tast2129/Grooving-Shredders/README.md

# This is the git for The Grooving Shredders 23-24 Capstone Team

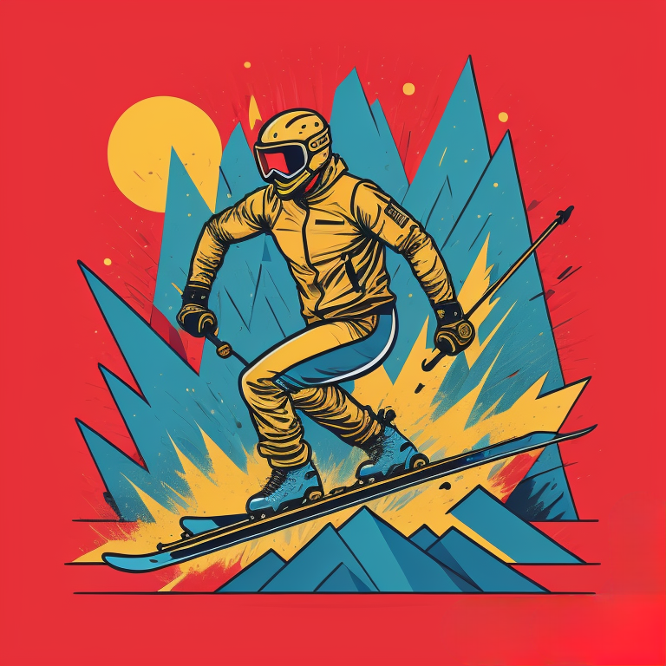
[picture p1: Images/Grooving Shredders Final Logo.png]


Project Sponsor: Augustus Aerospace

Frequency band: 1.24GHz

Git contact: Wes McEvoy @ westonmcevoy@gmail.com

# Table of Contents

* For patch antenna design of phased array see files in "AnsysHFSS"
* For HackRF and Pluto transmitter code see files in "GNU Radio"
* For delay and sum beamforming algorithm see:
  * "Python": "delay_and_sum_synthesis.ipynb"
* For beamforming IP block (in construction, low-level implementation of delay and sum algorithm) see files in "HDL"
* For RFSoC PYNQ layer code see "PYNQ"
* For motor code and hardware setup image, see "Arduino"
* For PCB files for AFE and patch antennas see "Gerber Files"

# Project Background

For 8 months, our team worked to build a digital beamformer in the FPGA fabric of the RFSoC 4x2 by AMD Xilinx. Although we ran out of time to fully debug the hardware configuration we developed, we learned a lot about the board, RF, and DSP and generated some pretty cool results along the way. All radiation patterns seen on this git were generated with the help of our custom test system.

System Flowchart:
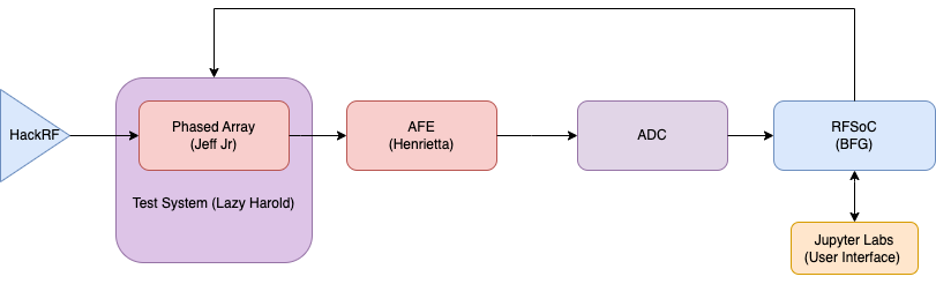
[picture p2: Images/Flowchart.png]
Flowchart


# Custom Components

Phased Array:

Phased_Array

Turntable Test System:

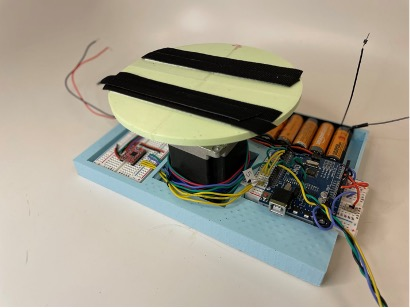
[picture p3: Images/Test_System.jpg]
Test_System


Analog Front End Board:

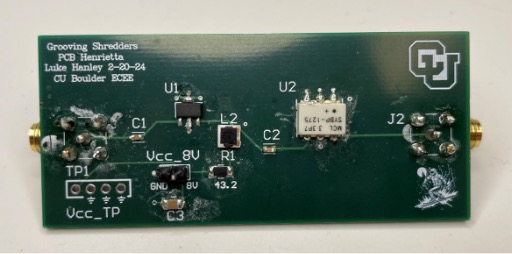
[picture p4: Images/AFE_PCB.jpg]
AFE_PCB


# Results

The environment we generated the following results in:

Setup

Radiation Pattern for COTS Dipole Antenna:

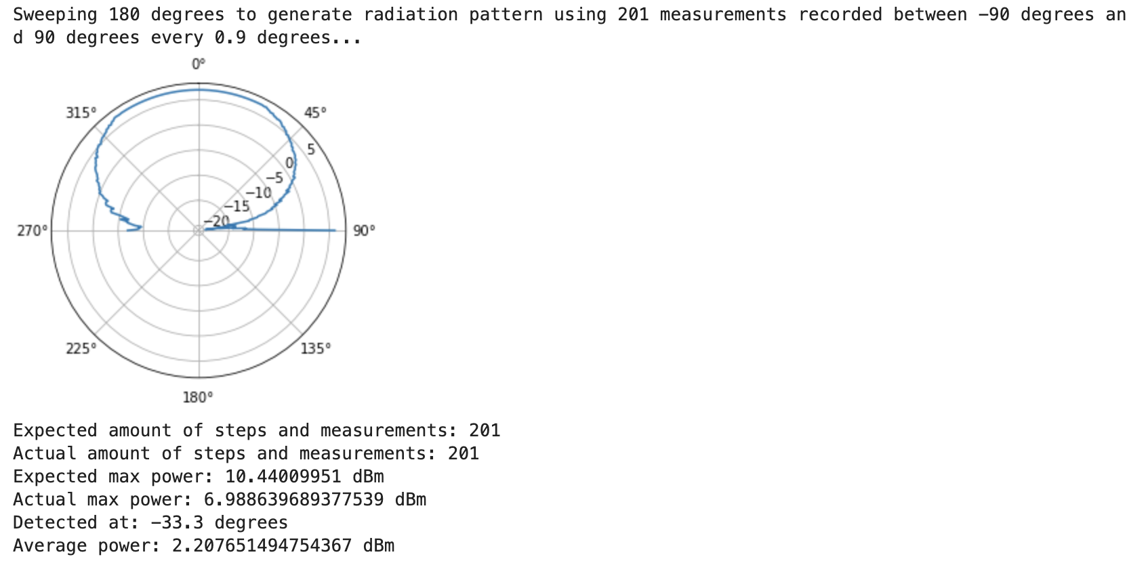
[picture p5: Images/Dipole_Pattern.png]
Dipole_Pattern


Radiation Pattern for Custom Patch Antenna:

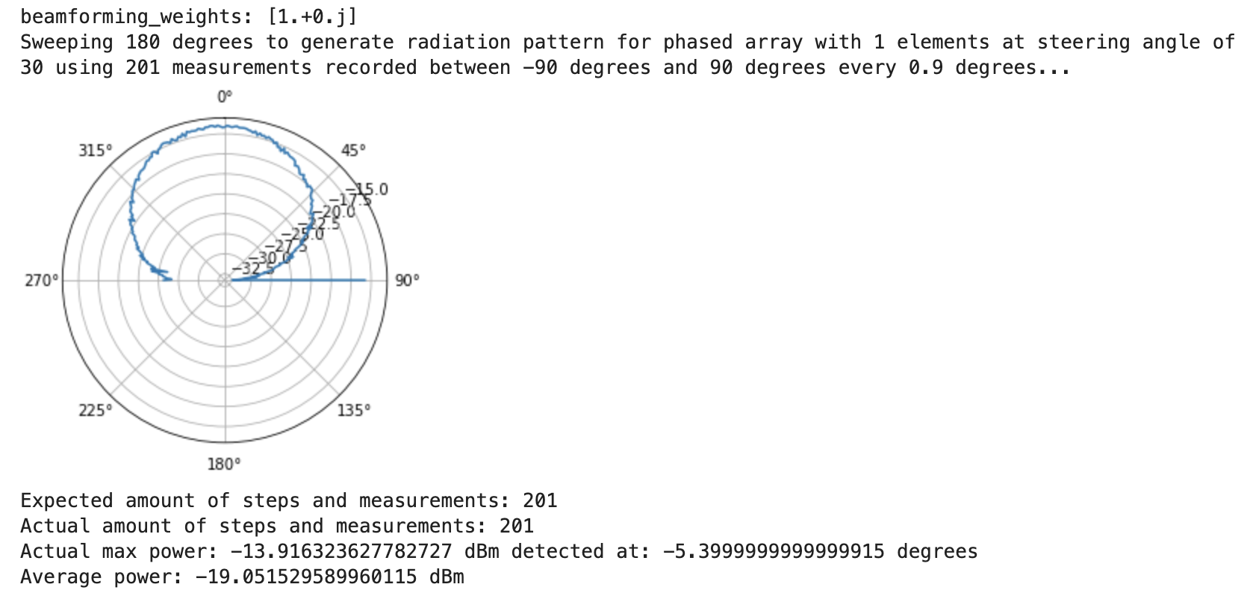
[picture p6: Images/Patch_Pattern.png]
Patch_Pattern


Normalized Radiation Pattern for Phased Array performing Analog Beamforming:

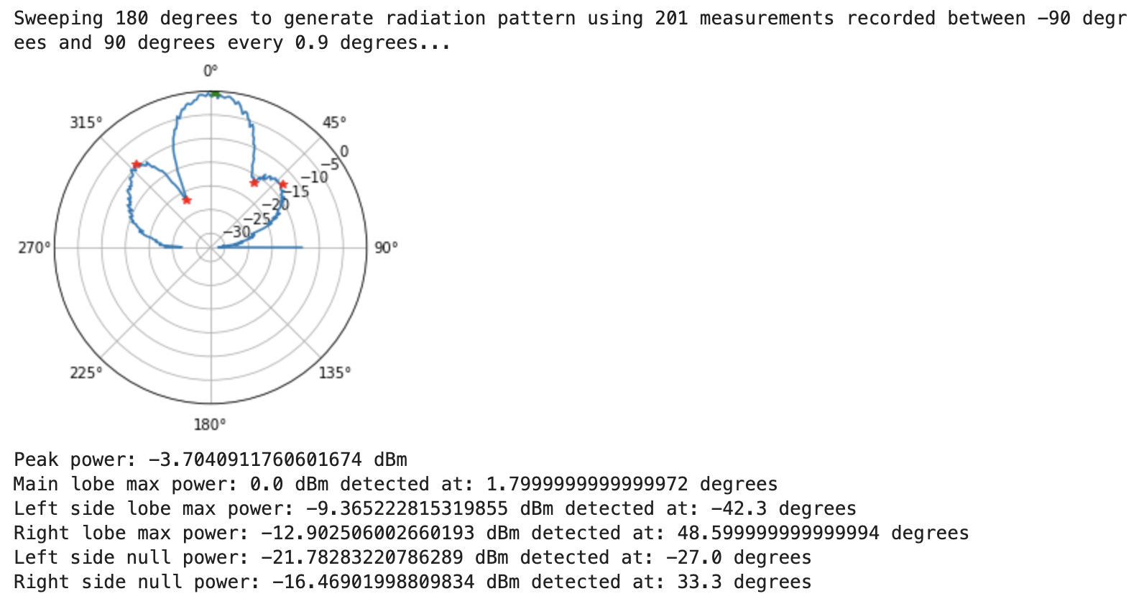
[picture p7: Images/Broadside_Pattern.png]
Array_Pattern


The best looking radiation pattern we generated:

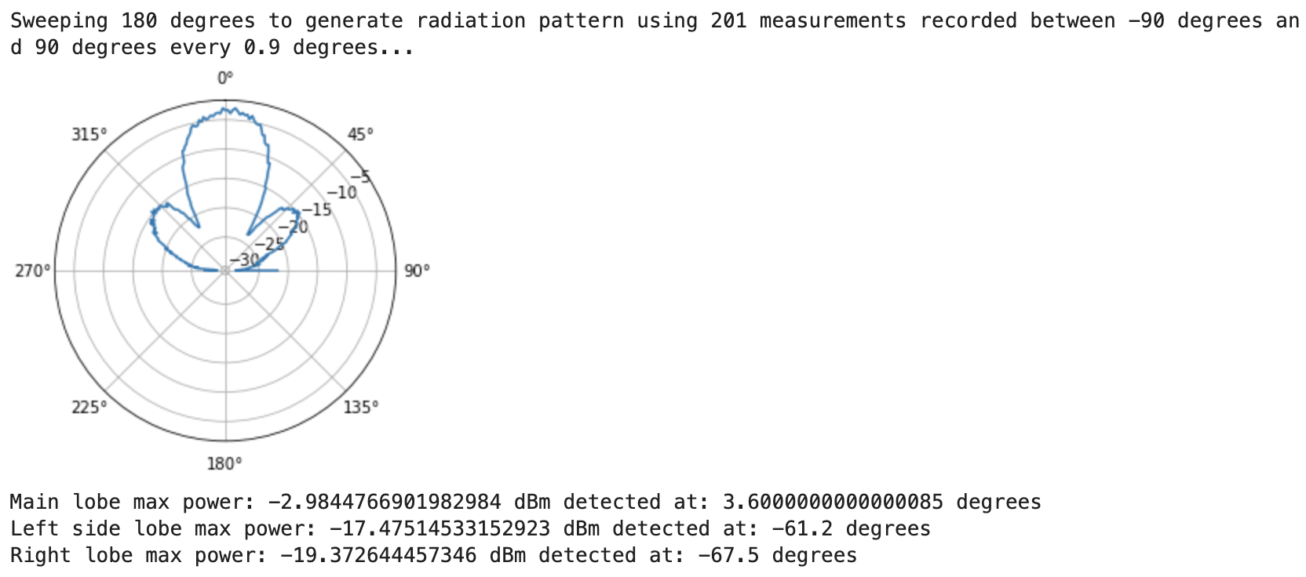
[picture p8: Images/Phased_Array_Pattern.png]
Pristine_Pattern


# Delay and sum algorithm synthesized by "delay_and_sum_synthesis.ipynb" in "Python"

Whenever a transmitter is located at some angle off of a phased array's broadside, each element receives the same signal with a different phase shift:

beamforming1

If we try to sum the signal received by the 4 elements, we get a lot of nonsense:

beamforming2

Instead, let's undo the phase shifts by multiplying each element's data by beamforming weights calculated using simple trig and the known angle of the transmitter off of the array's broadside and the spacing of the elements in the array:

beamforming3

Now when we sum the signal received by the 4 elements, not only have we received the original transmitted signal, but with around 4x the amplitude!

beamforming4

For this reason, it's incredibly important to ensure any phase shifts induced by hardware are corrected or compensated so as to make the beamforming as effective as possible:

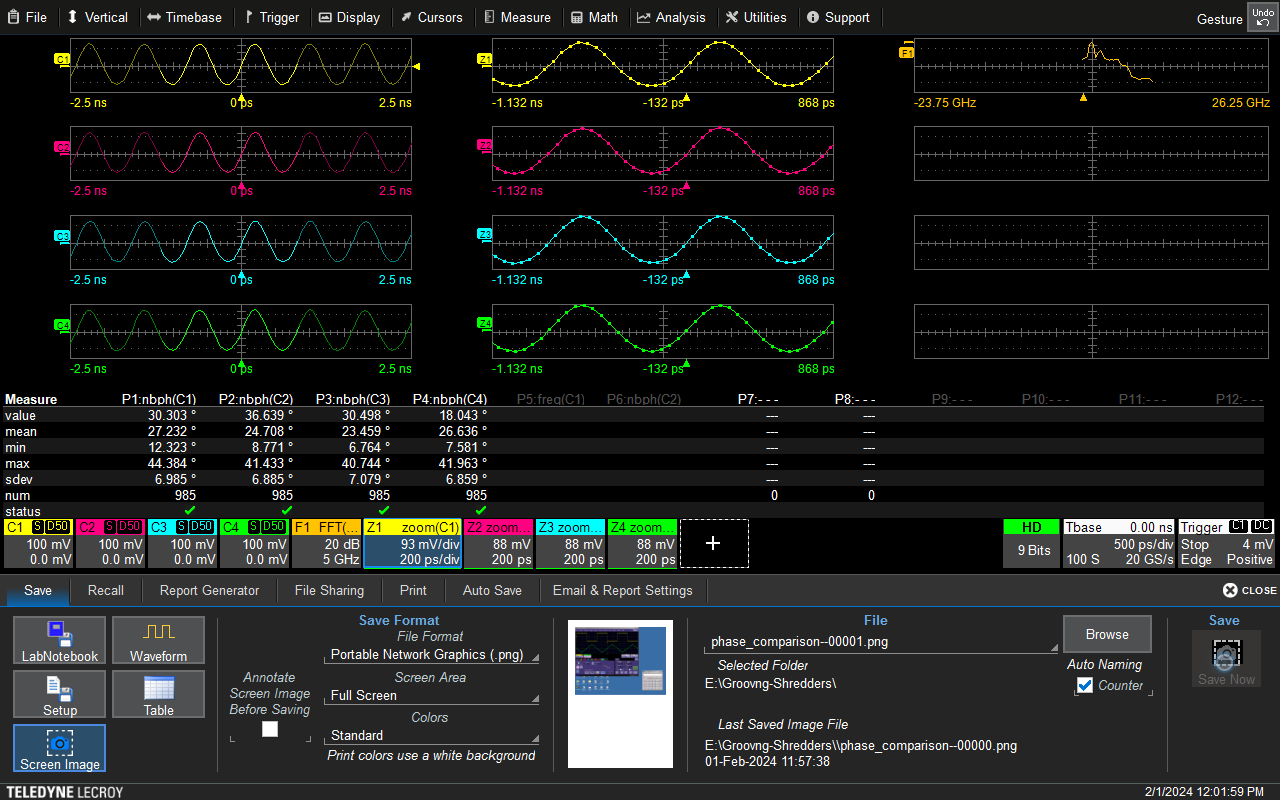
[picture p9: Images/Scope_Phase.png]
Phase


# References

https://www.rfsoc-pynq.io/

https://pynq.readthedocs.io/en/latest/

https://www.xilinx.com/products/design-tools/vitis/vitis-hls.html#resources

https://discuss.pynq.io/

https://docs.amd.com/r/en-US/ds926-zynq-ultrascale-plus-rfsoc/RF-ADC-Electrical-Characteristics

https://pysdr.org/content/doa.html
