tast2129/Grooving-Shredders/Images/Test_Setup1.jpeg

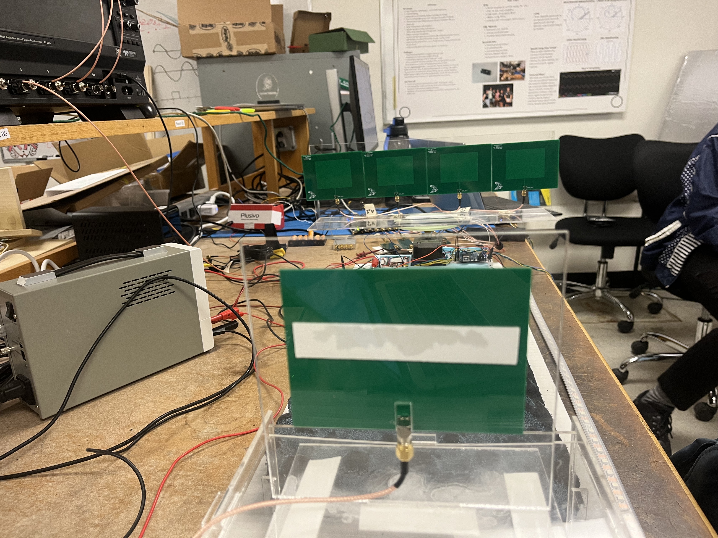
Images/Test_Setup1.jpeg
