tast2129/Grooving-Shredders/HDL/Auxilary_Modules/AXI_AdderBase.v

/* 
 * AXI data adder block taking four 128-bit input data and outputs them
 * This block is completely unnecessary and serves to confirm we're interfacing
 * correctly before implementing the adder portion of this block
*/
module axi_adder #(
    parameter SDATA_WIDTH = 128,
    parameter MDATA_WIDTH = 128,     // SDATA_WIDTH + 1
    parameter SSAMPLE_WIDTH = 8,
    parameter MSAMPLE_WIDTH = 8,   // SSAMPLE_WIDTH
    parameter WEIGHT_WIDTH = 8
    ) 
    (
    input clock,
    input resetn,

    // these will be the multiplication factor for all 16 samples in each channel, each should be <1
    input [WEIGHT_WIDTH-1:0] bWeight00_imag, input [WEIGHT_WIDTH-1:0] bWeight00_real,
    input [WEIGHT_WIDTH-1:0] bWeight01_imag, input [WEIGHT_WIDTH-1:0] bWeight01_real,
    input [WEIGHT_WIDTH-1:0] bWeight20_imag, input [WEIGHT_WIDTH-1:0] bWeight20_real,
    input [WEIGHT_WIDTH-1:0] bWeight21_imag, input [WEIGHT_WIDTH-1:0] bWeight21_real,
    
    /* all axis prefixed variables should be inferred per UG994 because of the 
     * use of the AXI standard naming convention */

    input [0:0]             S00_axi_awid,
    input [48:0]            S00_axi_awaddr,
    input [7:0]             S00_axi_awlen,
    input [2:0]             S00_axi_awsize,
    input [1:0]             S00_axi_awburst,
    input                   S00_axi_awlock,
    input [3:0]             S00_axi_awcache,
    input [2:0]             S00_axi_awprot,
    input                   S00_axi_awregion,
    input [3:0]             S00_axi_awqos,
    input                   S00_axi_awvalid, //zero when reset
    output                  S00_axi_awready, //zero when reset
    input [15:0]            S00_axi_wstrb,
    input                   S00_axi_wlast,
    input                   S00_axi_wvalid, //zero when reset
    output                  S00_axi_wready, //zero when reset
    output [5:0]            S00_axi_bid,
    output [1:0]            S00_axi_bresp,
    output                  S00_axi_bvalid, //zero when reset
    input                   S00_axi_bready, //zero when reset
    input [SDATA_WIDTH-1:0] S00_axi_wdata, // 16 8-bit samples
    input [5:0]             S00_axi_arid,
    input [63:0]            S00_axi_araddr,
    input [7:0]             S00_axi_arlen,
    input [2:0]             S00_axi_arsize,
    input [1:0]             S00_axi_arburst,
    input                   S00_axi_arlock,
    input [3:0]             S00_axi_arcache,
    input [2:0]             S00_axi_arprot,
    input                   S00_axi_arregion,
    input [3:0]             S00_axi_arqos,
    input                   S00_axi_arvalid, //zero when reset
    output                  S00_axi_arready, //zero when reset
    output [1:0]            S00_axi_rresp,
    output                  S00_axi_rlast,
    output                  S00_axi_rvalid, //zero when reset
    input                   S00_axi_rready, //zero when reset
    output[SDATA_WIDTH-1:0] S00_axi_rdata, // 16 8-bit samples
		
    input [5:0]             S01_axi_awid,
    input [48:0]            S01_axi_awaddr,
    input [7:0]             S01_axi_awlen,
    input [2:0]             S01_axi_awsize,
    input [1:0]             S01_axi_awburst,
    input                   S01_axi_awlock,
    input [3:0]             S01_axi_awcache,
    input [2:0]             S01_axi_awprot,
    input                   S01_axi_awregion,
    input [3:0]             S01_axi_awqos,
    input                   S01_axi_awvalid, //zero when reset
    output                  S01_axi_awready, //zero when reset
    input [15:0]            S01_axi_wstrb,
    input                   S01_axi_wlast,
    input                   S01_axi_wvalid, //zero when reset
    output                  S01_axi_wready, //zero when reset
    output [5:0]            S01_axi_bid,
    output [1:0]            S01_axi_bresp,
    output                  S01_axi_bvalid, //zero when reset
    input                   S01_axi_bready, //zero when reset
    input [SDATA_WIDTH-1:0] S01_axi_wdata, // 16 8-bit samples
    input [5:0]             S01_axi_arid,
    input [63:0]            S01_axi_araddr,
    input [7:0]             S01_axi_arlen,
    input [2:0]             S01_axi_arsize,
    input [1:0]             S01_axi_arburst,
    input                   S01_axi_arlock,
    input [3:0]             S01_axi_arcache,
    input [2:0]             S01_axi_arprot,
    input                   S01_axi_arregion,
    input [3:0]             S01_axi_arqos,
    input                   S01_axi_arvalid, //zero when reset
    output                  S01_axi_arready, //zero when reset
    output [1:0]            S01_axi_rresp,
    output                  S01_axi_rlast,
    output                  S01_axi_rvalid, //zero when reset
    input                   S01_axi_rready, //zero when reset
    output[SDATA_WIDTH-1:0] S01_axi_rdata, // 16 8-bit samples
		
    input [5:0]             S21_axi_awid,
    input [48:0]            S21_axi_awaddr,
    input [7:0]             S21_axi_awlen,
    input [2:0]             S21_axi_awsize,
    input [1:0]             S21_axi_awburst,
    input                   S21_axi_awlock,
    input [3:0]             S21_axi_awcache,
    input [2:0]             S21_axi_awprot,
    input                   S21_axi_awregion,
    input [3:0]             S21_axi_awqos,
    input                   S21_axi_awvalid, //zero when reset
    output                  S21_axi_awready, //zero when reset
    input [15:0]            S21_axi_wstrb,
    input                   S21_axi_wlast,
    input                   S21_axi_wvalid, //zero when reset
    output                  S21_axi_wready, //zero when reset
    output [5:0]            S21_axi_bid,
    output [1:0]            S21_axi_bresp,
    output                  S21_axi_bvalid, //zero when reset
    input                   S21_axi_bready, //zero when reset
    input [SDATA_WIDTH-1:0] S21_axi_wdata, // 16 8-bit samples
    input [5:0]             S21_axi_arid,
    input [63:0]            S21_axi_araddr,
    input [7:0]             S21_axi_arlen,
    input [2:0]             S21_axi_arsize,
    input [1:0]             S21_axi_arburst,
    input                   S21_axi_arlock,
    input [3:0]             S21_axi_arcache,
    input [2:0]             S21_axi_arprot,
    input                   S21_axi_arregion,
    input [3:0]             S21_axi_arqos,
    input                   S21_axi_arvalid, //zero when reset
    output                  S21_axi_arready, //zero when reset
    output [1:0]            S21_axi_rresp,
    output                  S21_axi_rlast,
    output                  S21_axi_rvalid, //zero when reset
    input                   S21_axi_rready, //zero when reset
    output[SDATA_WIDTH-1:0] S21_axi_rdata, // 16 8-bit samples
		
    input [5:0]             S20_axi_awid,
    input [48:0]            S20_axi_awaddr,
    input [7:0]             S20_axi_awlen,
    input [2:0]             S20_axi_awsize,
    input [1:0]             S20_axi_awburst,
    input                   S20_axi_awlock,
    input [3:0]             S20_axi_awcache,
    input [2:0]             S20_axi_awprot,
    input                   S20_axi_awregion,
    input [3:0]             S20_axi_awqos,
    input                   S20_axi_awvalid, //zero when reset
    output                  S20_axi_awready, //zero when reset
    input [15:0]            S20_axi_wstrb,
    input                   S20_axi_wlast,
    input                   S20_axi_wvalid, //zero when reset
    output                  S20_axi_wready, //zero when reset
    output [5:0]            S20_axi_bid,
    output [1:0]            S20_axi_bresp,
    output                  S20_axi_bvalid, //zero when reset
    input                   S20_axi_bready, //zero when reset
    input [SDATA_WIDTH-1:0] S20_axi_wdata, // 16 8-bit samples
    input [5:0]             S20_axi_arid,
    input [63:0]            S20_axi_araddr,
    input [7:0]             S20_axi_arlen,
    input [2:0]             S20_axi_arsize,
    input [1:0]             S20_axi_arburst,
    input                   S20_axi_arlock,
    input [3:0]             S20_axi_arcache,
    input [2:0]             S20_axi_arprot,
    input                   S20_axi_arregion,
    input [3:0]             S20_axi_arqos,
    input                   S20_axi_arvalid, //zero when reset
    output                  S20_axi_arready, //zero when reset
    output [1:0]            S20_axi_rresp,
    output                  S20_axi_rlast,
    output                  S20_axi_rvalid, //zero when reset
    input                   S20_axi_rready, //zero when reset
    output[SDATA_WIDTH-1:0] S20_axi_rdata, // 16 8-bit samples
	
    output [5:0]            M00_axi_awid,
    output [48:0]           M00_axi_awaddr,
    output [7:0]            M00_axi_awlen,
    output [2:0]            M00_axi_awsize,
    output [1:0]            M00_axi_awburst,
    output                  M00_axi_awlock,
    output [3:0]            M00_axi_awcache,
    output [2:0]            M00_axi_awprot,
    output                  M00_axi_awregion,
    output [3:0]            M00_axi_awqos,
    output                  M00_axi_awvalid, //zero when reset
    input                   M00_axi_awready, //zero when reset
    output [15:0]           M00_axi_wstrb,
    output                  M00_axi_wlast,
    output                  M00_axi_wvalid, //zero when reset
    input                   M00_axi_wready, //zero when reset
    output[MDATA_WIDTH-1:0] M00_axi_wdata, // 16 8-bit samples
    output [5:0]            M00_axi_arid,
    output [63:0]           M00_axi_araddr,
    output [7:0]            M00_axi_arlen,
    output [2:0]            M00_axi_arsize,
    output [1:0]            M00_axi_arburst,
    output                  M00_axi_arlock,
    output [3:0]            M00_axi_arcache,
    output [2:0]            M00_axi_arprot,
    output                  M00_axi_arregion,
    output [3:0]            M00_axi_arqos,
    output                  M00_axi_arvalid, //zero when reset
    input                   M00_axi_arready, //zero when reset
    input  [1:0]            M00_axi_rresp,
    input                   M00_axi_rlast,
    input                   M00_axi_rvalid, //zero when reset
    output                  M00_axi_rready, //zero when reset
    input  [5:0]            M00_axi_bid,
    input  [1:0]            M00_axi_bresp,
    input                   M00_axi_bvalid, //zero when reset
    output                  M00_axi_bready, //zero when reset
    input [MDATA_WIDTH-1:0] M00_axi_rdata, // 16 8-bit samples

    output [5:0]            M01_axi_awid,
    output [48:0]           M01_axi_awaddr,
    output [7:0]            M01_axi_awlen,
    output [2:0]            M01_axi_awsize,
    output [1:0]            M01_axi_awburst,
    output                  M01_axi_awlock,
    output [3:0]            M01_axi_awcache,
    output [2:0]            M01_axi_awprot,
    output                  M01_axi_awregion,
    output [3:0]            M01_axi_awqos,
    output                  M01_axi_awvalid, //zero when reset
    input                   M01_axi_awready, //zero when reset
    output [15:0]           M01_axi_wstrb,
    output                  M01_axi_wlast,
    output                  M01_axi_wvalid, //zero when reset
    input                   M01_axi_wready, //zero when reset
    output[MDATA_WIDTH-1:0] M01_axi_wdata, // 16 8-bit samples
    output [5:0]            M01_axi_arid,
    output [63:0]           M01_axi_araddr,
    output [7:0]            M01_axi_arlen,
    output [2:0]            M01_axi_arsize,
    output [1:0]            M01_axi_arburst,
    output                  M01_axi_arlock,
    output [3:0]            M01_axi_arcache,
    output [2:0]            M01_axi_arprot,
    output                  M01_axi_arregion,
    output [3:0]            M01_axi_arqos,
    output                  M01_axi_arvalid, //zero when reset
    input                   M01_axi_arready, //zero when reset
    input  [1:0]            M01_axi_rresp,
    input                   M01_axi_rlast,
    input                   M01_axi_rvalid, //zero when reset
    output                  M01_axi_rready, //zero when reset
    input  [5:0]            M01_axi_bid,
    input  [1:0]            M01_axi_bresp,
    input                   M01_axi_bvalid, //zero when reset
    output                  M01_axi_bready, //zero when reset
    input [MDATA_WIDTH-1:0] M01_axi_rdata, // 16 8-bit samples

    output [5:0]            M21_axi_awid,
    output [48:0]           M21_axi_awaddr,
    output [7:0]            M21_axi_awlen,
    output [2:0]            M21_axi_awsize,
    output [1:0]            M21_axi_awburst,
    output                  M21_axi_awlock,
    output [3:0]            M21_axi_awcache,
    output [2:0]            M21_axi_awprot,
    output                  M21_axi_awregion,
    output [3:0]            M21_axi_awqos,
    output                  M21_axi_awvalid, //zero when reset
    input                   M21_axi_awready, //zero when reset
    output [15:0]           M21_axi_wstrb,
    output                  M21_axi_wlast,
    output                  M21_axi_wvalid, //zero when reset
    input                   M21_axi_wready, //zero when reset
    output[MDATA_WIDTH-1:0] M21_axi_wdata, // 16 8-bit samples
    output [5:0]            M21_axi_arid,
    output [63:0]           M21_axi_araddr,
    output [7:0]            M21_axi_arlen,
    output [2:0]            M21_axi_arsize,
    output [1:0]            M21_axi_arburst,
    output                  M21_axi_arlock,
    output [3:0]            M21_axi_arcache,
    output [2:0]            M21_axi_arprot,
    output                  M21_axi_arregion,
    output [3:0]            M21_axi_arqos,
    output                  M21_axi_arvalid, //zero when reset
    input                   M21_axi_arready, //zero when reset
    input  [1:0]            M21_axi_rresp,
    input                   M21_axi_rlast,
    input                   M21_axi_rvalid, //zero when reset
    output                  M21_axi_rready, //zero when reset
    input  [5:0]            M21_axi_bid,
    input  [1:0]            M21_axi_bresp,
    input                   M21_axi_bvalid, //zero when reset
    output                  M21_axi_bready, //zero when reset
    input [MDATA_WIDTH-1:0] M21_axi_rdata, // 16 8-bit samples
    
    output [5:0]            M20_axi_awid,
    output [48:0]           M20_axi_awaddr,
    output [7:0]            M20_axi_awlen,
    output [2:0]            M20_axi_awsize,
    output [1:0]            M20_axi_awburst,
    output                  M20_axi_awlock,
    output [3:0]            M20_axi_awcache,
    output [2:0]            M20_axi_awprot,
    output                  M20_axi_awregion,
    output [3:0]            M20_axi_awqos,
    output                  M20_axi_awvalid, //zero when reset
    input                   M20_axi_awready, //zero when reset
    output [15:0]           M20_axi_wstrb,
    output                  M20_axi_wlast,
    output                  M20_axi_wvalid, //zero when reset
    input                   M20_axi_wready, //zero when reset
    output[MDATA_WIDTH-1:0] M20_axi_wdata, // 16 8-bit samples
    output [5:0]            M20_axi_arid,
    output [63:0]           M20_axi_araddr,
    output [7:0]            M20_axi_arlen,
    output [2:0]            M20_axi_arsize,
    output [1:0]            M20_axi_arburst,
    output                  M20_axi_arlock,
    output [3:0]            M20_axi_arcache,
    output [2:0]            M20_axi_arprot,
    output                  M20_axi_arregion,
    output [3:0]            M20_axi_arqos,
    output                  M20_axi_arvalid, //zero when reset
    input                   M20_axi_arready, //zero when reset
    input  [1:0]            M20_axi_rresp,
    input                   M20_axi_rlast,
    input                   M20_axi_rvalid, //zero when reset
    output                  M20_axi_rready, //zero when reset
    input  [5:0]            M20_axi_bid,
    input  [1:0]            M20_axi_bresp,
    input                   M20_axi_bvalid, //zero when reset
    output                  M20_axi_bready, //zero when reset
    input [MDATA_WIDTH-1:0] M20_axi_rdata // 16 8-bit samples
    );

    assign M00_axi_awid = S00_axi_awid;
    assign M00_axi_awaddr = S00_axi_awaddr;
    assign M00_axi_awlen = S00_axi_awlen;
    assign M00_axi_awsize = S00_axi_awsize;
    assign M00_axi_awburst = S00_axi_awburst;
    assign M00_axi_awlock = S00_axi_awlock;
    assign M00_axi_awcache = S00_axi_awcache;
    assign M00_axi_awprot = S00_axi_awprot;
    assign M00_axi_awregion = S00_axi_awregion;
    assign M00_axi_awqos = S00_axi_awqos;
    assign M00_axi_awvalid = S00_axi_awvalid;
    assign M00_axi_awready = S00_axi_awready; //zero when reset
    assign M00_axi_wstrb = S00_axi_wstrb;
    assign M00_axi_wlast = S00_axi_wlast;
    assign M00_axi_wvalid = S00_axi_wvalid; //zero when reset
    assign M00_axi_wready = S00_axi_wready; //zero when reset
    assign M00_axi_bid = S00_axi_bid;
    assign M00_axi_bresp = S00_axi_bresp;
    assign M00_axi_bvalid = S00_axi_bvalid; //zero when reset
    assign M00_axi_bready = S00_axi_bready; //zero when reset
    assign M00_axi_wdata = S00_axi_wdata; // 16 8-bit samples
    assign M00_axi_arid = S00_axi_arid;
    assign M00_axi_araddr = S00_axi_araddr;
    assign M00_axi_arlen = S00_axi_arlen;
    assign M00_axi_arsize = S00_axi_arsize;
    assign M00_axi_arburst = S00_axi_arburst;
    assign M00_axi_arlock = S00_axi_arlock;
    assign M00_axi_arcache = S00_axi_arcache;
    assign M00_axi_arprot = S00_axi_arprot;
    assign M00_axi_arregion = S00_axi_arregion;
    assign M00_axi_arqos = S00_axi_arqos;
    assign M00_axi_arvalid = S00_axi_arvalid; //zero when reset
    assign M00_axi_arready = S00_axi_arready; //zero when reset
    assign M00_axi_rresp = S00_axi_rresp;
    assign M00_axi_rlast = S00_axi_rlast;
    assign M00_axi_rvalid = S00_axi_rvalid; //zero when reset
    assign M00_axi_rready = S00_axi_rready; //zero when reset
    assign M00_axi_rdata = S00_axi_rdata; // 16 8-bit samples

    assign M01_axi_awid = S01_axi_awid;
    assign M01_axi_awaddr = S01_axi_awaddr;
    assign M01_axi_awlen = S01_axi_awlen;
    assign M01_axi_awsize = S01_axi_awsize;
    assign M01_axi_awburst = S01_axi_awburst;
    assign M01_axi_awlock = S01_axi_awlock;
    assign M01_axi_awcache = S01_axi_awcache;
    assign M01_axi_awprot = S01_axi_awprot;
    assign M01_axi_awregion = S01_axi_awregion;
    assign M01_axi_awqos = S01_axi_awqos;
    assign M01_axi_awvalid = S01_axi_awvalid;
    assign M01_axi_awready = S01_axi_awready; //zero when reset
    assign M01_axi_wstrb = S01_axi_wstrb;
    assign M01_axi_wlast = S01_axi_wlast;
    assign M01_axi_wvalid = S01_axi_wvalid; //zero when reset
    assign M01_axi_wready = S01_axi_wready; //zero when reset
    assign M01_axi_bid = S01_axi_bid;
    assign M01_axi_bresp = S01_axi_bresp;
    assign M01_axi_bvalid = S01_axi_bvalid; //zero when reset
    assign M01_axi_bready = S01_axi_bready; //zero when reset
    assign M01_axi_wdata = S01_axi_wdata; // 16 8-bit samples
    assign M01_axi_arid = S01_axi_arid;
    assign M01_axi_araddr = S01_axi_araddr;
    assign M01_axi_arlen = S01_axi_arlen;
    assign M01_axi_arsize = S01_axi_arsize;
    assign M01_axi_arburst = S01_axi_arburst;
    assign M01_axi_arlock = S01_axi_arlock;
    assign M01_axi_arcache = S01_axi_arcache;
    assign M01_axi_arprot = S01_axi_arprot;
    assign M01_axi_arregion = S01_axi_arregion;
    assign M01_axi_arqos = S01_axi_arqos;
    assign M01_axi_arvalid = S01_axi_arvalid; //zero when reset
    assign M01_axi_arready = S01_axi_arready; //zero when reset
    assign M01_axi_rresp = S01_axi_rresp;
    assign M01_axi_rlast = S01_axi_rlast;
    assign M01_axi_rvalid = S01_axi_rvalid; //zero when reset
    assign M01_axi_rready = S01_axi_rready; //zero when reset
    assign M01_axi_rdata = S01_axi_rdata; // 16 8-bit samples

    assign M20_axi_awid = S20_axi_awid;
    assign M20_axi_awaddr = S20_axi_awaddr;
    assign M20_axi_awlen = S20_axi_awlen;
    assign M20_axi_awsize = S20_axi_awsize;
    assign M20_axi_awburst = S20_axi_awburst;
    assign M20_axi_awlock = S20_axi_awlock;
    assign M20_axi_awcache = S20_axi_awcache;
    assign M20_axi_awprot = S20_axi_awprot;
    assign M20_axi_awregion = S20_axi_awregion;
    assign M20_axi_awqos = S20_axi_awqos;
    assign M20_axi_awvalid = S20_axi_awvalid;
    assign M20_axi_awready = S20_axi_awready; //zero when reset
    assign M20_axi_wstrb = S20_axi_wstrb;
    assign M20_axi_wlast = S20_axi_wlast;
    assign M20_axi_wvalid = S20_axi_wvalid; //zero when reset
    assign M20_axi_wready = S20_axi_wready; //zero when reset
    assign M20_axi_bid = S20_axi_bid;
    assign M20_axi_bresp = S20_axi_bresp;
    assign M20_axi_bvalid = S20_axi_bvalid; //zero when reset
    assign M20_axi_bready = S20_axi_bready; //zero when reset
    assign M20_axi_wdata = S20_axi_wdata; // 16 8-bit samples
    assign M20_axi_arid = S20_axi_arid;
    assign M20_axi_araddr = S20_axi_araddr;
    assign M20_axi_arlen = S20_axi_arlen;
    assign M20_axi_arsize = S20_axi_arsize;
    assign M20_axi_arburst = S20_axi_arburst;
    assign M20_axi_arlock = S20_axi_arlock;
    assign M20_axi_arcache = S20_axi_arcache;
    assign M20_axi_arprot = S20_axi_arprot;
    assign M20_axi_arregion = S20_axi_arregion;
    assign M20_axi_arqos = S20_axi_arqos;
    assign M20_axi_arvalid = S20_axi_arvalid; //zero when reset
    assign M20_axi_arready = S20_axi_arready; //zero when reset
    assign M20_axi_rresp = S20_axi_rresp;
    assign M20_axi_rlast = S20_axi_rlast;
    assign M20_axi_rvalid = S20_axi_rvalid; //zero when reset
    assign M20_axi_rready = S20_axi_rready; //zero when reset
    assign M20_axi_rdata = S20_axi_rdata; // 16 8-bit samples

    assign M21_axi_awid = S21_axi_awid;
    assign M21_axi_awaddr = S21_axi_awaddr;
    assign M21_axi_awlen = S21_axi_awlen;
    assign M21_axi_awsize = S21_axi_awsize;
    assign M21_axi_awburst = S21_axi_awburst;
    assign M21_axi_awlock = S21_axi_awlock;
    assign M21_axi_awcache = S21_axi_awcache;
    assign M21_axi_awprot = S21_axi_awprot;
    assign M21_axi_awregion = S21_axi_awregion;
    assign M21_axi_awqos = S21_axi_awqos;
    assign M21_axi_awvalid = S21_axi_awvalid;
    assign M21_axi_awready = S21_axi_awready; //zero when reset
    assign M21_axi_wstrb = S21_axi_wstrb;
    assign M21_axi_wlast = S21_axi_wlast;
    assign M21_axi_wvalid = S21_axi_wvalid; //zero when reset
    assign M21_axi_wready = S21_axi_wready; //zero when reset
    assign M21_axi_bid = S21_axi_bid;
    assign M21_axi_bresp = S21_axi_bresp;
    assign M21_axi_bvalid = S21_axi_bvalid; //zero when reset
    assign M21_axi_bready = S21_axi_bready; //zero when reset
    assign M21_axi_wdata = S21_axi_wdata; // 16 8-bit samples
    assign M21_axi_arid = S21_axi_arid;
    assign M21_axi_araddr = S21_axi_araddr;
    assign M21_axi_arlen = S21_axi_arlen;
    assign M21_axi_arsize = S21_axi_arsize;
    assign M21_axi_arburst = S21_axi_arburst;
    assign M21_axi_arlock = S21_axi_arlock;
    assign M21_axi_arcache = S21_axi_arcache;
    assign M21_axi_arprot = S21_axi_arprot;
    assign M21_axi_arregion = S21_axi_arregion;
    assign M21_axi_arqos = S21_axi_arqos;
    assign M21_axi_arvalid = S21_axi_arvalid; //zero when reset
    assign M21_axi_arready = S21_axi_arready; //zero when reset
    assign M21_axi_rresp = S21_axi_rresp;
    assign M21_axi_rlast = S21_axi_rlast;
    assign M21_axi_rvalid = S21_axi_rvalid; //zero when reset
    assign M21_axi_rready = S21_axi_rready; //zero when reset
    assign M21_axi_rdata = S21_axi_rdata; // 16 8-bit samples
    //always@(posedge clock) begin
    //end
    
endmodule
