tast2129/Grooving-Shredders/(commit log)

2024-03-01 Updated Arduino and IT1
2024-03-05 Updates to IT Arduino and PYNQ
2024-03-11 Stuck getting ADC to transfer ADC data
2024-03-11 fixed syntax error on line 58 in AXIS_Multiplier.v
    [AXIS_Multiplier.v]
2024-03-19 Backing up board files
2024-03-21 Removed beamforming testing and new beamforming because they are so huge (ADC data)
2024-04-10 set slave tready when -resetn
    [AXIS_Adder.v]
2024-04-12 fixed my cs-in-hdl errors
    [AXIS_Adder.v]
2024-04-12 bufferWidth var type fixes
    [AXIS_Adder.v]
2024-04-12 moved 'samples' and buffer widths to parameters
2024-04-15 fixed twos complement arithmetic
    [AXIS_Adder.v]
2024-04-15 oops missed a semicolon
    [AXIS_Adder.v]
2024-04-17 fixed blocking assignments in reset
    [AXIS_Adder.v]
2024-04-22 'SAMPLES' was wrong, off by factor of 2 bc bytes. Also adding tready assignment if not reset
    [AXIS_Multiplier.v]
2024-04-22 'SAMPLES' wasn't wrong but I sure was
    [AXIS_Multiplier.v]
2024-04-23 Added comment with problems with this implementation that I noticed after testing the overlay
    [AXIS_Multiplier.v]
2024-04-23 removing tkeep set in multiplier, adding tkeep = 0 to if resetn in adder
    [AXIS_Multiplier.v]
2024-04-23 Updated 'PROBLEMS' comment after overlay testing
    [AXIS_Multiplier.v]
2024-05-01 Patch Antenna Jeff Final Rev
2024-05-06 Updating read me
    [AcceptanceTesting_testPlan.xlsx]
